EloItsMee/RP2040-CRSF-Controller/README.md

# Custom RP2040-based Drone Companion Computer board

See PowerPoint in main repo for details on the project!

Files should include STL for mounting to a SpeedyBee drone frame, and the PCB files with BOM.
