EloItsMee/RP2040-CRSF-Controller/Mechanical/RP2040-CRSF-Controller-EDM/RP2040-CRSF-Controller_BottomDecalImage_0.png

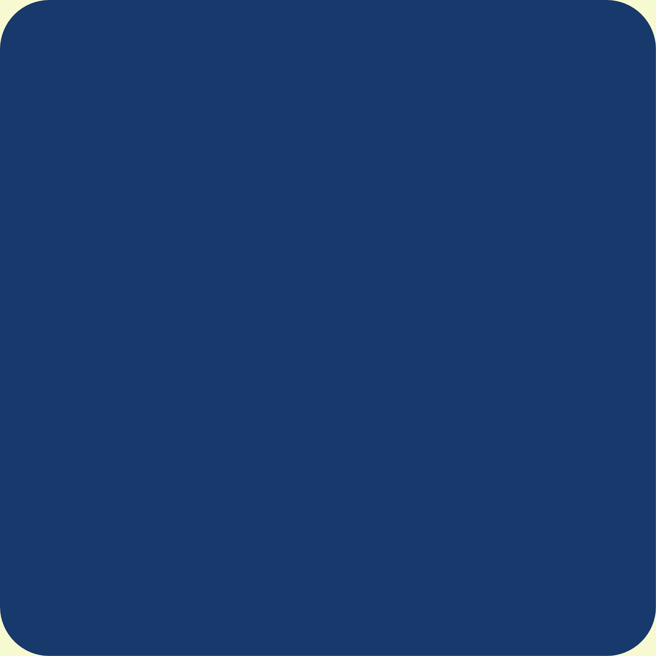
Mechanical/RP2040-CRSF-Controller-EDM/RP2040-CRSF-Controller_BottomDecalImage_0.png
