EloItsMee/RP2040-CRSF-Controller/Mechanical/RP2040-CRSF-Controller.SLDASM

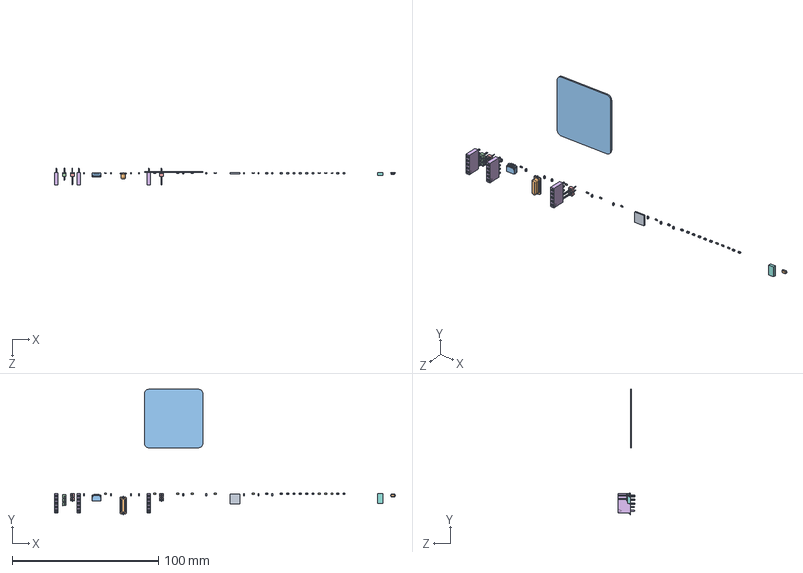
[picture p2: CAD file, 2024-03-07]
Mechanical/RP2040-CRSF-Controller.SLDASM
232.9 x 85.7 x 11.8 mm
RP2040-CRSF-Controller_BOARD
ABLS_ABLS-12.000MHZ-B4-T-1
QFN40P700X700X90_HS-57N_CMP-020-00023-1
SOT230P700X180-4N_CMP-019-00050-5
RESC0603(1608)_L_CMP-009-00176-3 x 9
RHDR5W74P0X254_1X5_1320X250X850P_2212S-05SG-85-1 x 3
SMTC-TSW-102-26-XX-S_CMP-1024-00327-1 x 2
TSW-103-XX-YY-S_TSW-103-26-G-S-1
SM04B-SRSS-TB(LFSN)_SM04B-SRSS-TB_LF___SN-1
PMEG2010ER115_PMEG2010ER,115-1
CAPC0603(1608)100_L_CMP-001-00075-4 x 18
