EloItsMee/RP2040-CRSF-Controller/Mechanical/RP2040-CRSF-Controller-EDM/CAPC0603(1608)100_L_CMP-001-00075-4.SLDPRT

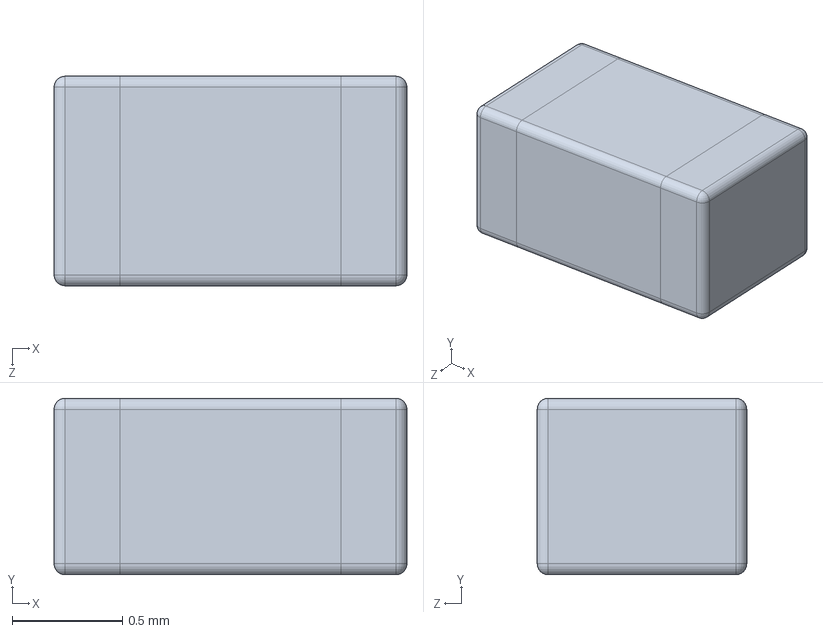
[picture p3: CAD file, 2024-03-07]
Mechanical/RP2040-CRSF-Controller-EDM/CAPC0603(1608)100_L_CMP-001-00075-4.SLDPRT
1.60 x 0.8 x 0.95 mm
