EloItsMee/RP2040-CRSF-Controller/Mechanical/RP2040-CRSF-Controller-EDM/SM04B-SRSS-TB(LFSN)_SM04B-SRSS-TB_LF___SN-1.SLDPRT

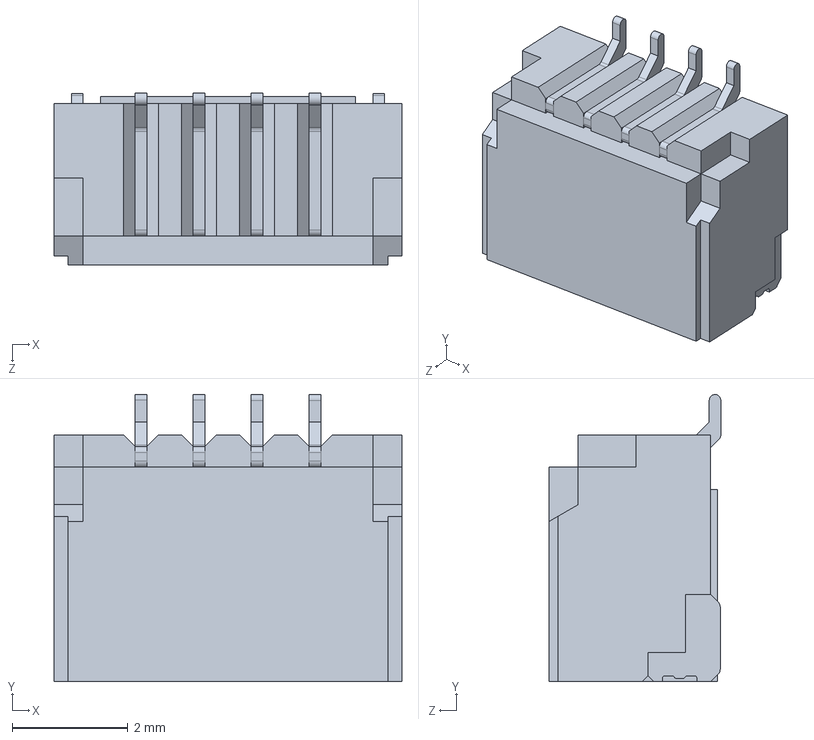
[picture p4: CAD file, 2024-03-07]
Mechanical/RP2040-CRSF-Controller-EDM/SM04B-SRSS-TB(LFSN)_SM04B-SRSS-TB_LF___SN-1.SLDPRT
6.00 x 4.95 x 2.96 mm
