EloItsMee/RP2040-CRSF-Controller/Mechanical/RP2040-CRSF-Controller-EDM/RP2040-CRSF-Controller_BOARD.SLDPRT

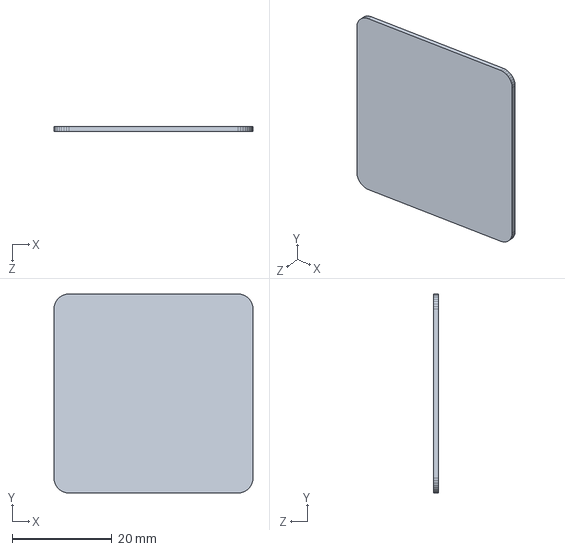
[picture p5: CAD file, 2024-03-07]
Mechanical/RP2040-CRSF-Controller-EDM/RP2040-CRSF-Controller_BOARD.SLDPRT
40.0 x 40.0 x 0.995 mm
