EloItsMee/RP2040-CRSF-Controller/Mechanical/RP2040-CRSF-Controller-EDM/ABLS_ABLS-12.000MHZ-B4-T-1.SLDPRT

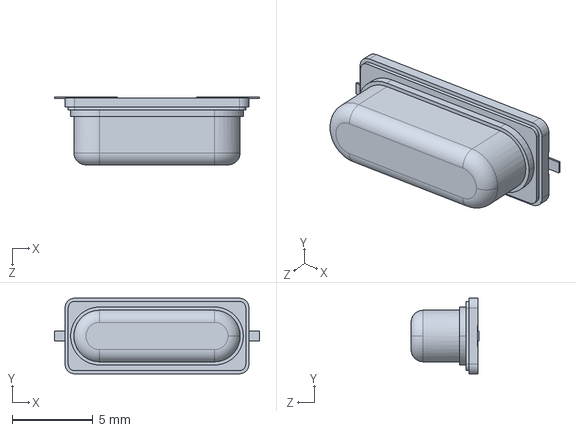
[picture p6: CAD file, 2024-03-07]
Mechanical/RP2040-CRSF-Controller-EDM/ABLS_ABLS-12.000MHZ-B4-T-1.SLDPRT
12.7 x 4.70 x 4.20 mm
