EloItsMee/RP2040-CRSF-Controller/Mechanical/RP2040-CRSF-Controller-EDM/PMEG2010ER115_PMEG2010ER,115-1.SLDPRT

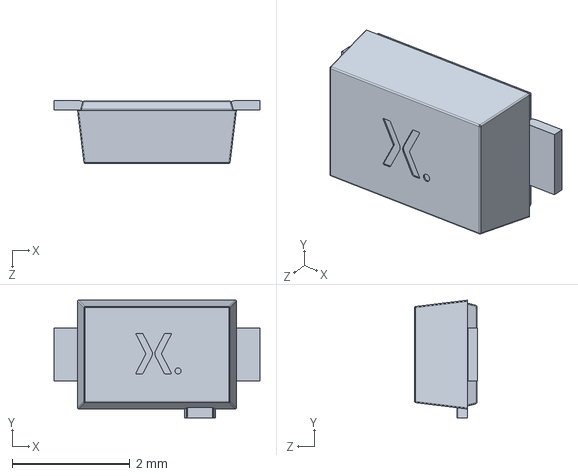
[picture p7: CAD file, 2024-03-07]
Mechanical/RP2040-CRSF-Controller-EDM/PMEG2010ER115_PMEG2010ER,115-1.SLDPRT
3.50 x 2.00 x 1.07 mm
