EloItsMee/RP2040-CRSF-Controller/Mechanical/RP2040-CRSF-Controller-EDM/RESC0603(1608)_L_CMP-009-00176-3.SLDPRT

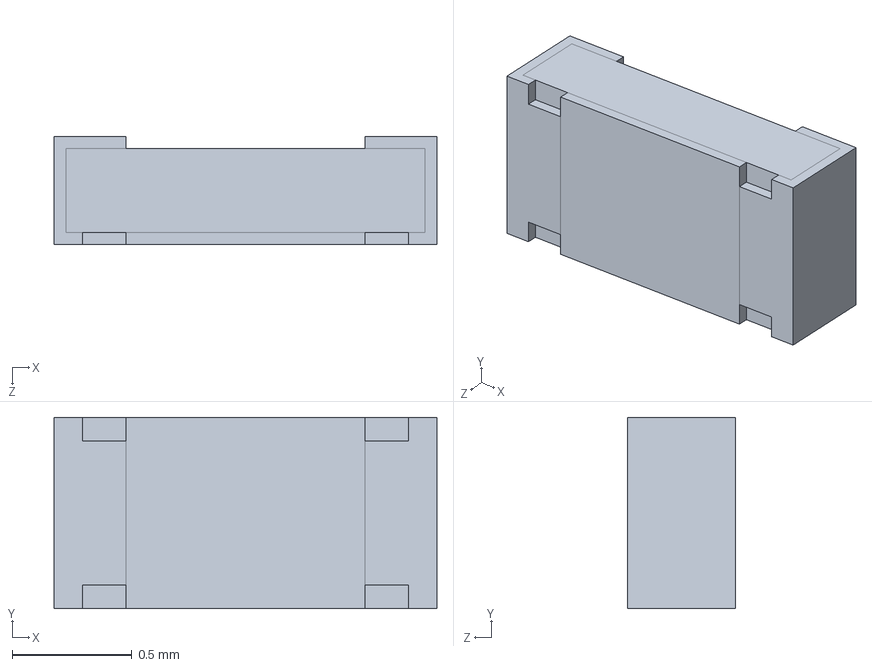
[picture p8: CAD file, 2024-03-07]
Mechanical/RP2040-CRSF-Controller-EDM/RESC0603(1608)_L_CMP-009-00176-3.SLDPRT
1.60 x 0.8 x 0.45 mm
