EloItsMee/RP2040-CRSF-Controller/Mechanical/RP2040-CRSF-Controller-EDM/QFN40P700X700X90_HS-57N_CMP-020-00023-1.SLDPRT

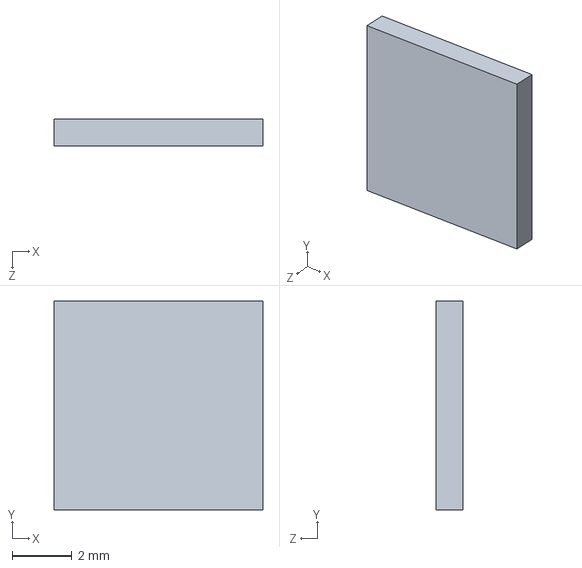
[picture p9: CAD file, 2024-03-07]
Mechanical/RP2040-CRSF-Controller-EDM/QFN40P700X700X90_HS-57N_CMP-020-00023-1.SLDPRT
7.00 x 7.00 x 0.9 mm
