EloItsMee/RP2040-CRSF-Controller/Mechanical/RP2040-CRSF-Controller-EDM/TSW-103-XX-YY-S_TSW-103-26-G-S-1.SLDPRT

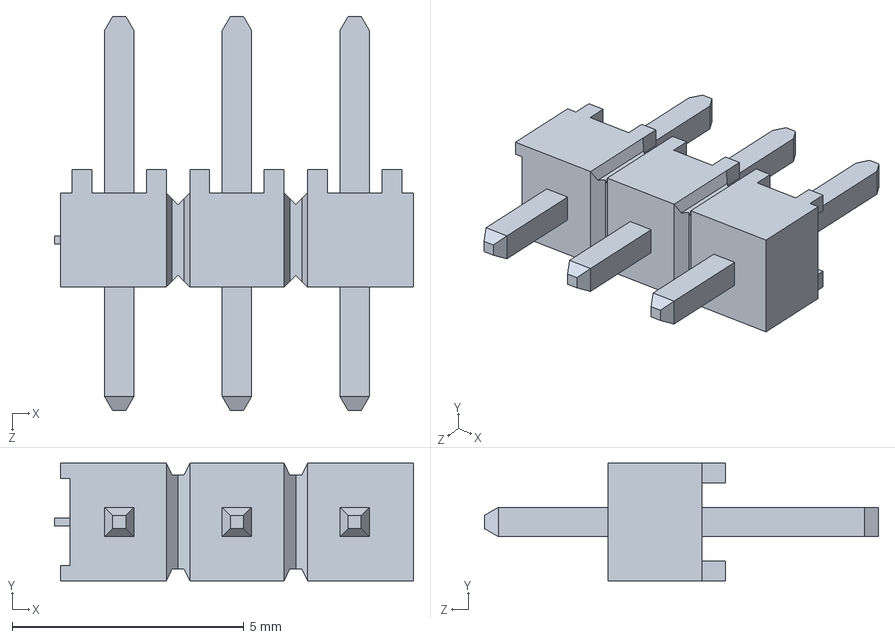
[picture p10: CAD file, 2024-03-07]
Mechanical/RP2040-CRSF-Controller-EDM/TSW-103-XX-YY-S_TSW-103-26-G-S-1.SLDPRT
7.75 x 2.54 x 8.51 mm
