EloItsMee/RP2040-CRSF-Controller/Mechanical/RP2040-CRSF-Controller-EDM/RHDR5W74P0X254_1X5_1320X250X850P_2212S-05SG-85-1.SLDPRT

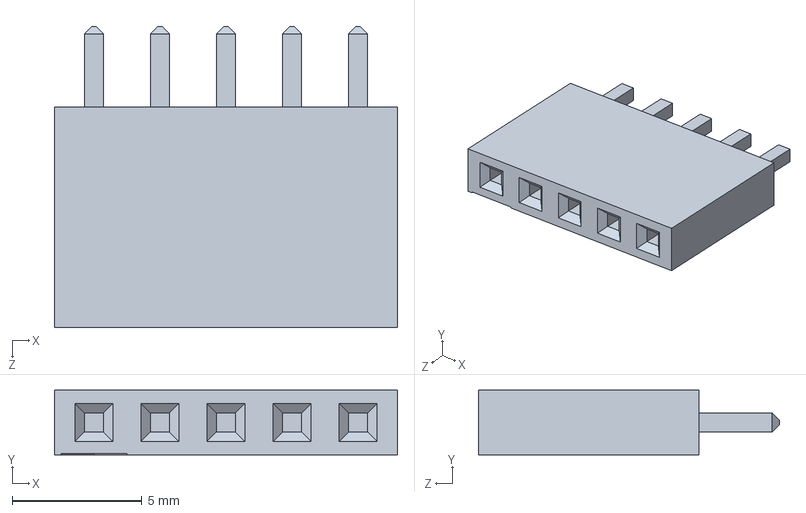
[picture p11: CAD file, 2024-03-07]
Mechanical/RP2040-CRSF-Controller-EDM/RHDR5W74P0X254_1X5_1320X250X850P_2212S-05SG-85-1.SLDPRT
13.2 x 2.50 x 11.6 mm
