EloItsMee/RP2040-CRSF-Controller/Mechanical/RP2040-CRSF-Controller-EDM/SOT230P700X180-4N_CMP-019-00050-5.SLDPRT

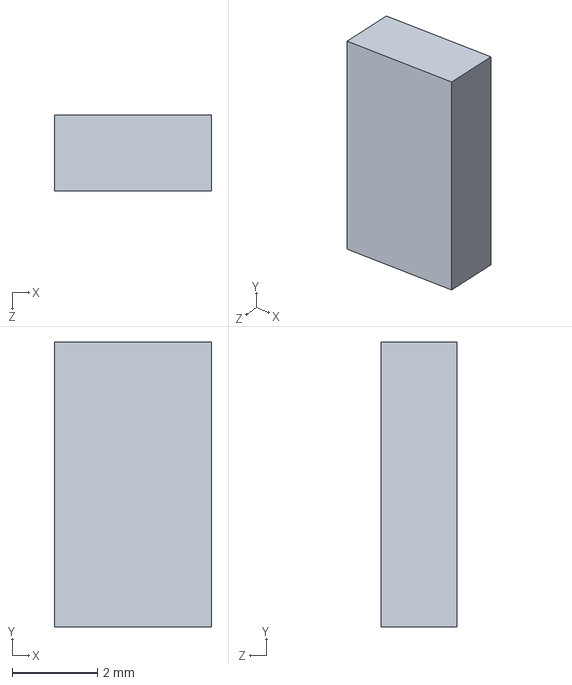
[picture p12: CAD file, 2024-03-07]
Mechanical/RP2040-CRSF-Controller-EDM/SOT230P700X180-4N_CMP-019-00050-5.SLDPRT
3.70 x 6.70 x 1.78 mm
