EloItsMee/RP2040-CRSF-Controller/Mechanical/RP2040-CRSF-Controller-EDM/SMTC-TSW-102-26-XX-S_CMP-1024-00327-1.SLDPRT

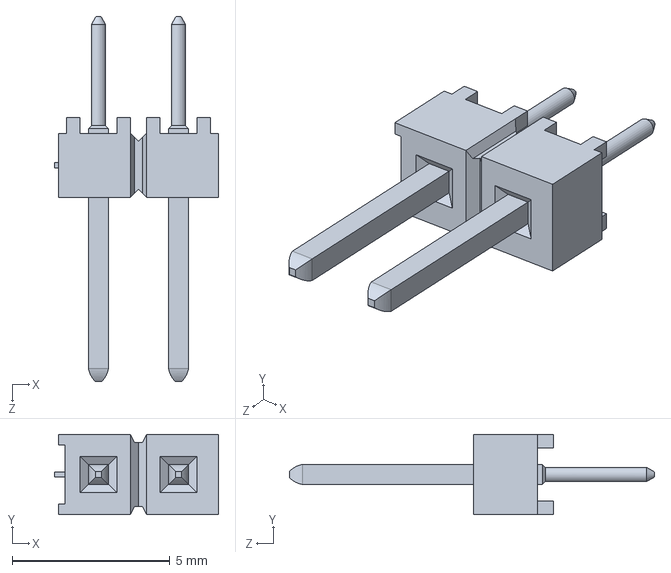
[picture p13: CAD file, 2024-03-07]
Mechanical/RP2040-CRSF-Controller-EDM/SMTC-TSW-102-26-XX-S_CMP-1024-00327-1.SLDPRT
5.21 x 2.54 x 11.6 mm
