EloItsMee/RP2040-CRSF-Controller/(list of files, cad)

Other CAD files:
Mechanical/RP2040-CRSF-Controller-EDM/Orig/ABLS_ABLS-12.000MHZ-B4-T_1.x_t
Mechanical/RP2040-CRSF-Controller-EDM/Orig/CAPC0603(1608)100_L_CMP-001-00075-4_1.x_t
Mechanical/RP2040-CRSF-Controller-EDM/Orig/PMEG2010ER115_PMEG2010ER,115_1.x_t
Mechanical/RP2040-CRSF-Controller-EDM/Orig/QFN40P700X700X90_HS-57N_CMP-020-00023-1_1.x_t
Mechanical/RP2040-CRSF-Controller-EDM/Orig/RESC0603(1608)_L_CMP-009-00176-3_1.x_t
Mechanical/RP2040-CRSF-Controller-EDM/Orig/RHDR5W74P0X254_1X5_1320X250X850P_2212S-05SG-85_1.x_t
Mechanical/RP2040-CRSF-Controller-EDM/Orig/SM04B-SRSS-TB(LFSN)_SM04B-SRSS-TB_LF__SN__1.x_t
Mechanical/RP2040-CRSF-Controller-EDM/Orig/SMTC-TSW-102-26-XX-S_CMP-1024-00327-1_1.x_t
Mechanical/RP2040-CRSF-Controller-EDM/Orig/SOT230P700X180-4N_CMP-019-00050-5_1.x_t
Mechanical/RP2040-CRSF-Controller-EDM/Orig/TSW-103-XX-YY-S_TSW-103-26-G-S_1.x_t
PCB/PCB1-EDM/RESC0603(1608)_L_CMP-009-00176-3.x_t
