EloItsMee/RP2040-CRSF-Controller/(list of files, drawings)

Other design files:
PCB/Pico-CRSF.PcbDoc
PCB/Pico-CRSF.SchDoc
PCB/RP2040-CRSF-RX.PrjPcb
